The-Jedi-Order/Lightsaber/README.md

# Lightsaber
Proyecto de prototipo de Lightsaber de Star Wars para la materia Sistemas Operativos Avanzados, UNLaM, 2do Cuatrimestre 2017
El mismo consta de un Sketch de Arduino y una aplicacion Android
